daveho/cpu2/hw/alu.sch

## KiCad design hw/alu.sch (2017-08-15)

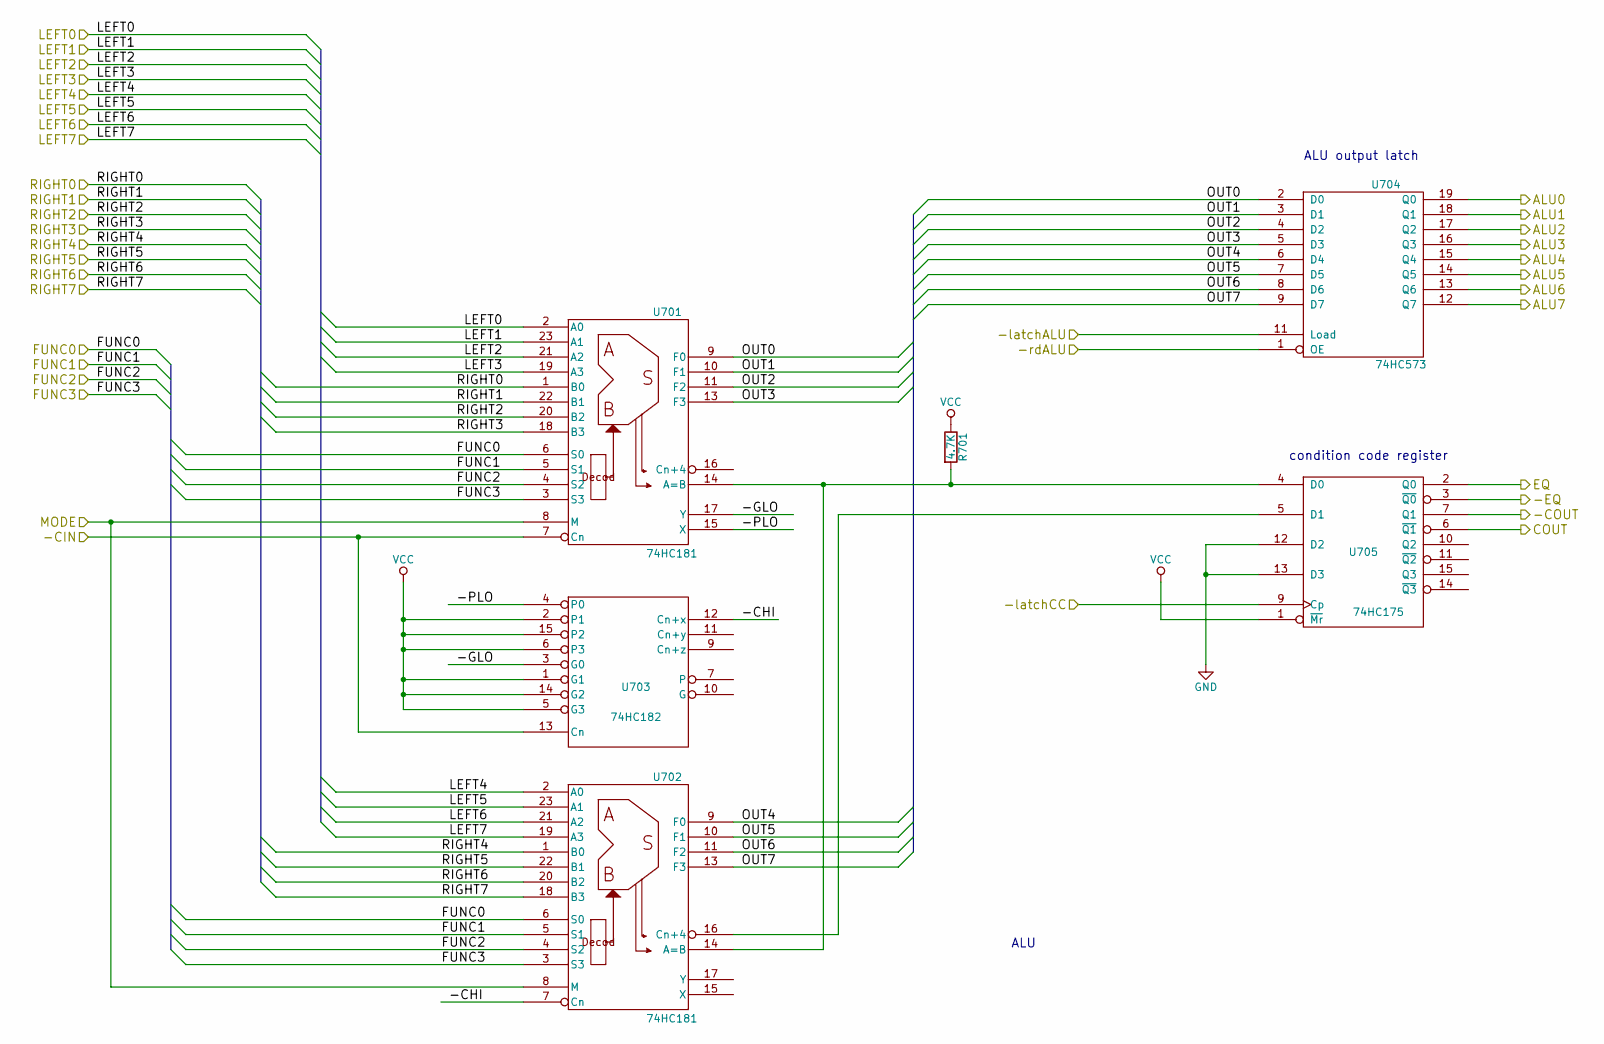
[picture p1: schematic alu.sch]

Parts:
R701: 4.7K
U701, U702: 74HC181
U703: 74HC182
U704: 74HC573
U705: 74HC175

Connections:
-CHI: U702.7 (Cn), U703.12 (Cn+x)
-CIN: U701.7 (Cn), U703.13 (Cn)
-COUT: U705.7 (Q1)
-EQ: U705.3 (~Q0)
-GLO: U701.17 (Y), U703.3 (G0)
-PLO: U701.15 (X), U703.4 (P0)
-latchALU: U704.11 (Load)
-latchCC: U705.9 (Cp)
-rdALU: U704.1 (OE)
ALU0: U704.19 (Q0)
ALU1: U704.18 (Q1)
ALU2: U704.17 (Q2)
ALU3: U704.16 (Q3)
ALU4: U704.15 (Q4)
ALU5: U704.14 (Q5)
ALU6: U704.13 (Q6)
ALU7: U704.12 (Q7)
COUT: U705.6 (~Q1)
EQ: U705.2 (Q0)
FUNC0: U701.6 (S0), U702.6 (S0)
FUNC1: U701.5 (S1), U702.5 (S1)
FUNC2: U701.4 (S2), U702.4 (S2)
FUNC3: U701.3 (S3), U702.3 (S3)
GND: U705.12 (D2), U705.13 (D3)
LEFT0: U701.2 (A0)
LEFT1: U701.23 (A1)
LEFT2: U701.21 (A2)
LEFT3: U701.19 (A3)
LEFT4: U702.2 (A0)
LEFT5: U702.23 (A1)
LEFT6: U702.21 (A2)
LEFT7: U702.19 (A3)
MODE: U701.8 (M), U702.8 (M)
unnamed: R701.2, U701.14 (A=B), U702.14 (A=B), U705.4 (D0)
unnamed: U702.16 (Cn+4), U705.5 (D1)
OUT0: U701.9 (F0), U704.2 (D0)
OUT1: U701.10 (F1), U704.3 (D1)
OUT2: U701.11 (F2), U704.4 (D2)
OUT3: U701.13 (F3), U704.5 (D3)
OUT4: U702.9 (F0), U704.6 (D4)
OUT5: U702.10 (F1), U704.7 (D5)
OUT6: U702.11 (F2), U704.8 (D6)
OUT7: U702.13 (F3), U704.9 (D7)
RIGHT0: U701.1 (B0)
RIGHT1: U701.22 (B1)
RIGHT2: U701.20 (B2)
RIGHT3: U701.18 (B3)
RIGHT4: U702.1 (B0)
RIGHT5: U702.22 (B1)
RIGHT6: U702.20 (B2)
RIGHT7: U702.18 (B3)
VCC: R701.1, U703.1 (G1), U703.2 (P1), U703.5 (G3), U703.6 (P3), U703.14 (G2), U703.15 (P2), U705.1 (~Mr)

Notes on the sheet:
ALU
condition code register
ALU output latch
