daveho/cpu2/hw/bus_ar.sch

## KiCad design hw/bus_ar.sch (2017-07-29)

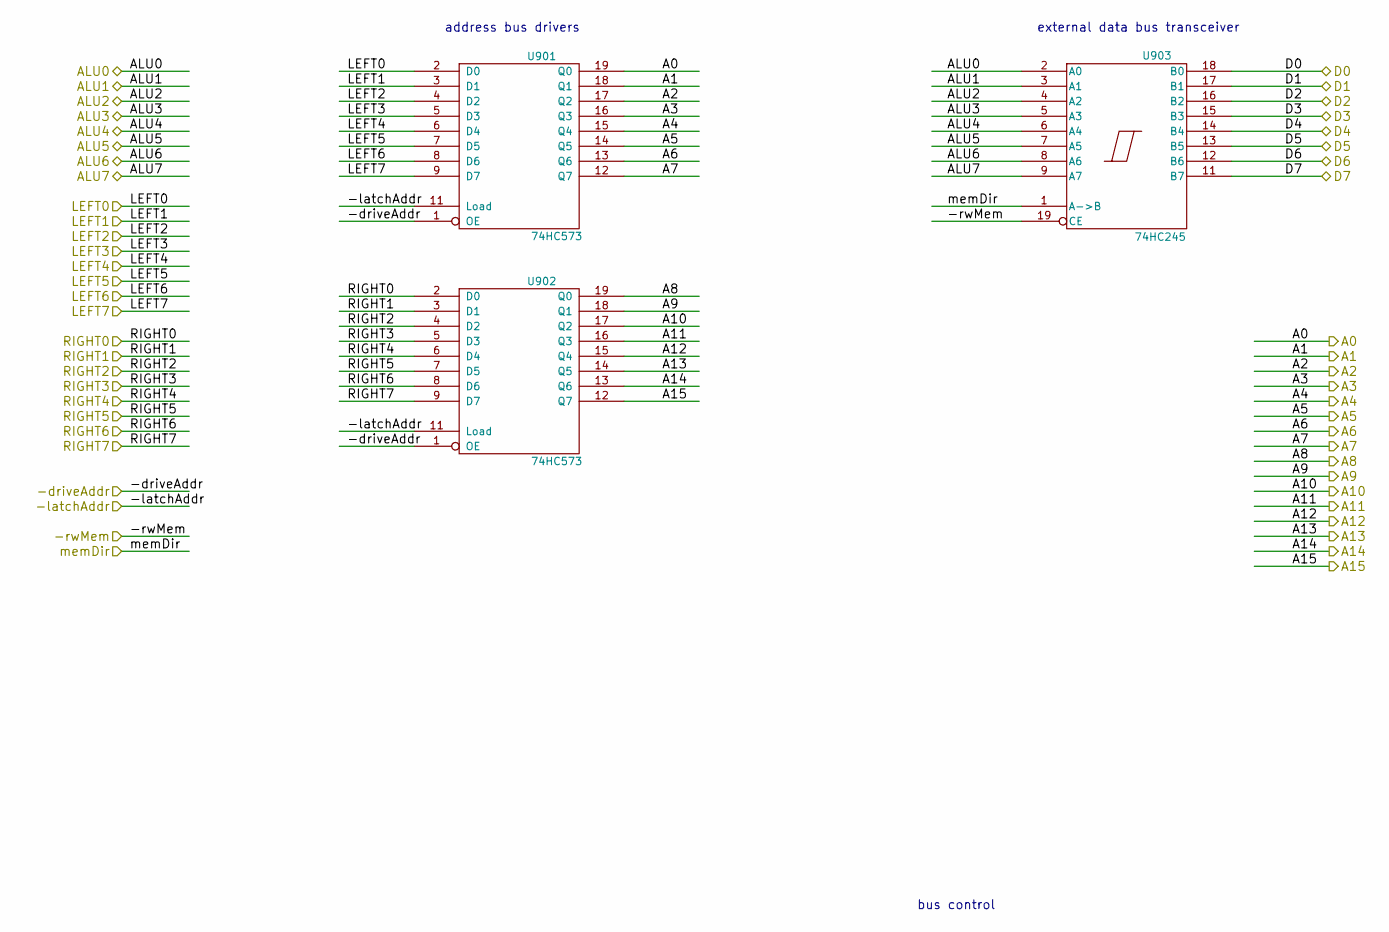
[picture p2: schematic bus_ar.sch]

Parts:
U901, U902: 74HC573
U903: 74HC245

Connections:
-driveAddr: U901.1 (OE), U902.1 (OE)
-latchAddr: U901.11 (Load), U902.11 (Load)
-rwMem: U903.19 (CE)
A0: U901.19 (Q0)
A1: U901.18 (Q1)
A2: U901.17 (Q2)
A3: U901.16 (Q3)
A4: U901.15 (Q4)
A5: U901.14 (Q5)
A6: U901.13 (Q6)
A7: U901.12 (Q7)
A8: U902.19 (Q0)
A9: U902.18 (Q1)
A10: U902.17 (Q2)
A11: U902.16 (Q3)
A12: U902.15 (Q4)
A13: U902.14 (Q5)
A14: U902.13 (Q6)
A15: U902.12 (Q7)
ALU0: U903.2 (A0)
ALU1: U903.3 (A1)
ALU2: U903.4 (A2)
ALU3: U903.5 (A3)
ALU4: U903.6 (A4)
ALU5: U903.7 (A5)
ALU6: U903.8 (A6)
ALU7: U903.9 (A7)
D0: U903.18 (B0)
D1: U903.17 (B1)
D2: U903.16 (B2)
D3: U903.15 (B3)
D4: U903.14 (B4)
D5: U903.13 (B5)
D6: U903.12 (B6)
D7: U903.11 (B7)
LEFT0: U901.2 (D0)
LEFT1: U901.3 (D1)
LEFT2: U901.4 (D2)
LEFT3: U901.5 (D3)
LEFT4: U901.6 (D4)
LEFT5: U901.7 (D5)
LEFT6: U901.8 (D6)
LEFT7: U901.9 (D7)
RIGHT0: U902.2 (D0)
RIGHT1: U902.3 (D1)
RIGHT2: U902.4 (D2)
RIGHT3: U902.5 (D3)
RIGHT4: U902.6 (D4)
RIGHT5: U902.7 (D5)
RIGHT6: U902.8 (D6)
RIGHT7: U902.9 (D7)
memDir: U903.1 (A->B)

Notes on the sheet:
bus control
address bus drivers
external data bus transceiver
