daveho/cpu2/hw/clockrst.sch

## KiCad design hw/clockrst.sch (2017-08-15)

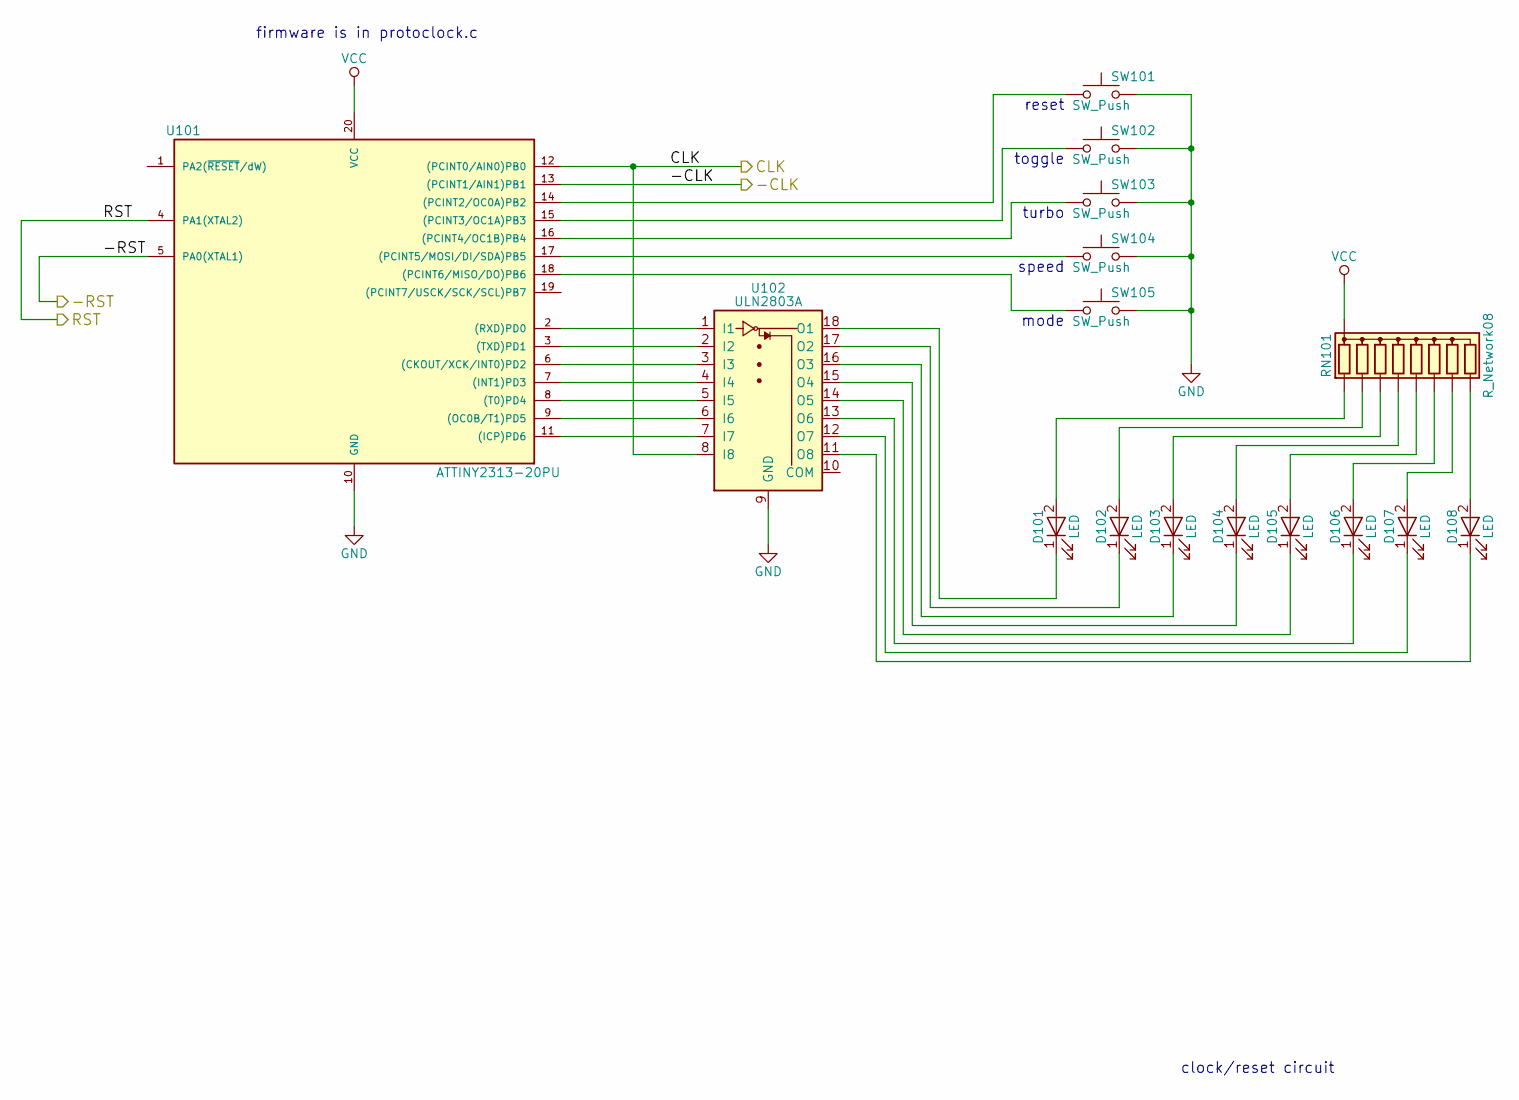
[picture p3: schematic clockrst.sch]

Parts:
D101, D102, D103, D104, D105, D106, D107, D108: LED
RN101: R_Network08; R_Array_SIP9
SW101, SW102, SW103, SW104, SW105: SW_Push
U101: ATTINY2313-20PU; DIP-20_W7.62mm
U102: ULN2803A

Connections:
-CLK: U101.13 ((PCINT1/AIN1)PB1)
-RST: U101.5 (PA0(XTAL1))
CLK: U101.12 ((PCINT0/AIN0)PB0), U102.8 (I8)
GND: SW101.2, SW102.2, SW103.2, SW104.2, SW105.2, U101.10 (GND), U102.9 (GND)
unnamed: D101.1 (K), U102.18 (O1)
unnamed: D101.2 (A), RN101.2 (R1)
unnamed: D102.1 (K), U102.17 (O2)
unnamed: D102.2 (A), RN101.3 (R2)
unnamed: D103.1 (K), U102.16 (O3)
unnamed: D103.2 (A), RN101.4 (R3)
unnamed: D104.1 (K), U102.15 (O4)
unnamed: D104.2 (A), RN101.5 (R4)
unnamed: D105.1 (K), U102.14 (O5)
unnamed: D105.2 (A), RN101.6 (R5)
unnamed: D106.1 (K), U102.13 (O6)
unnamed: D106.2 (A), RN101.7 (R6)
unnamed: D107.1 (K), U102.12 (O7)
unnamed: D107.2 (A), RN101.8 (R7)
unnamed: D108.1 (K), U102.11 (O8)
unnamed: D108.2 (A), RN101.9 (R8)
unnamed: SW101.1, U101.14 ((PCINT2/OC0A)PB2)
unnamed: SW102.1, U101.15 ((PCINT3/OC1A)PB3)
unnamed: SW103.1, U101.16 ((PCINT4/OC1B)PB4)
unnamed: SW104.1, U101.17 ((PCINT5/MOSI/DI/SDA)PB5)
unnamed: SW105.1, U101.18 ((PCINT6/MISO/DO)PB6)
unnamed: U101.2 ((RXD)PD0), U102.1 (I1)
unnamed: U101.3 ((TXD)PD1), U102.2 (I2)
unnamed: U101.6 ((CKOUT/XCK/INT0)PD2), U102.3 (I3)
unnamed: U101.7 ((INT1)PD3), U102.4 (I4)
unnamed: U101.8 ((T0)PD4), U102.5 (I5)
unnamed: U101.9 ((OC0B/T1)PD5), U102.6 (I6)
unnamed: U101.11 ((ICP)PD6), U102.7 (I7)
RST: U101.4 (PA1(XTAL2))
VCC: RN101.1 (common), U101.20 (VCC)

Notes on the sheet:
mode
speed
turbo
toggle
reset
clock/reset circuit
firmware is in protoclock.c
