daveho/cpu2/hw/earlyrst.sch

## KiCad design hw/earlyrst.sch (2017-08-15)

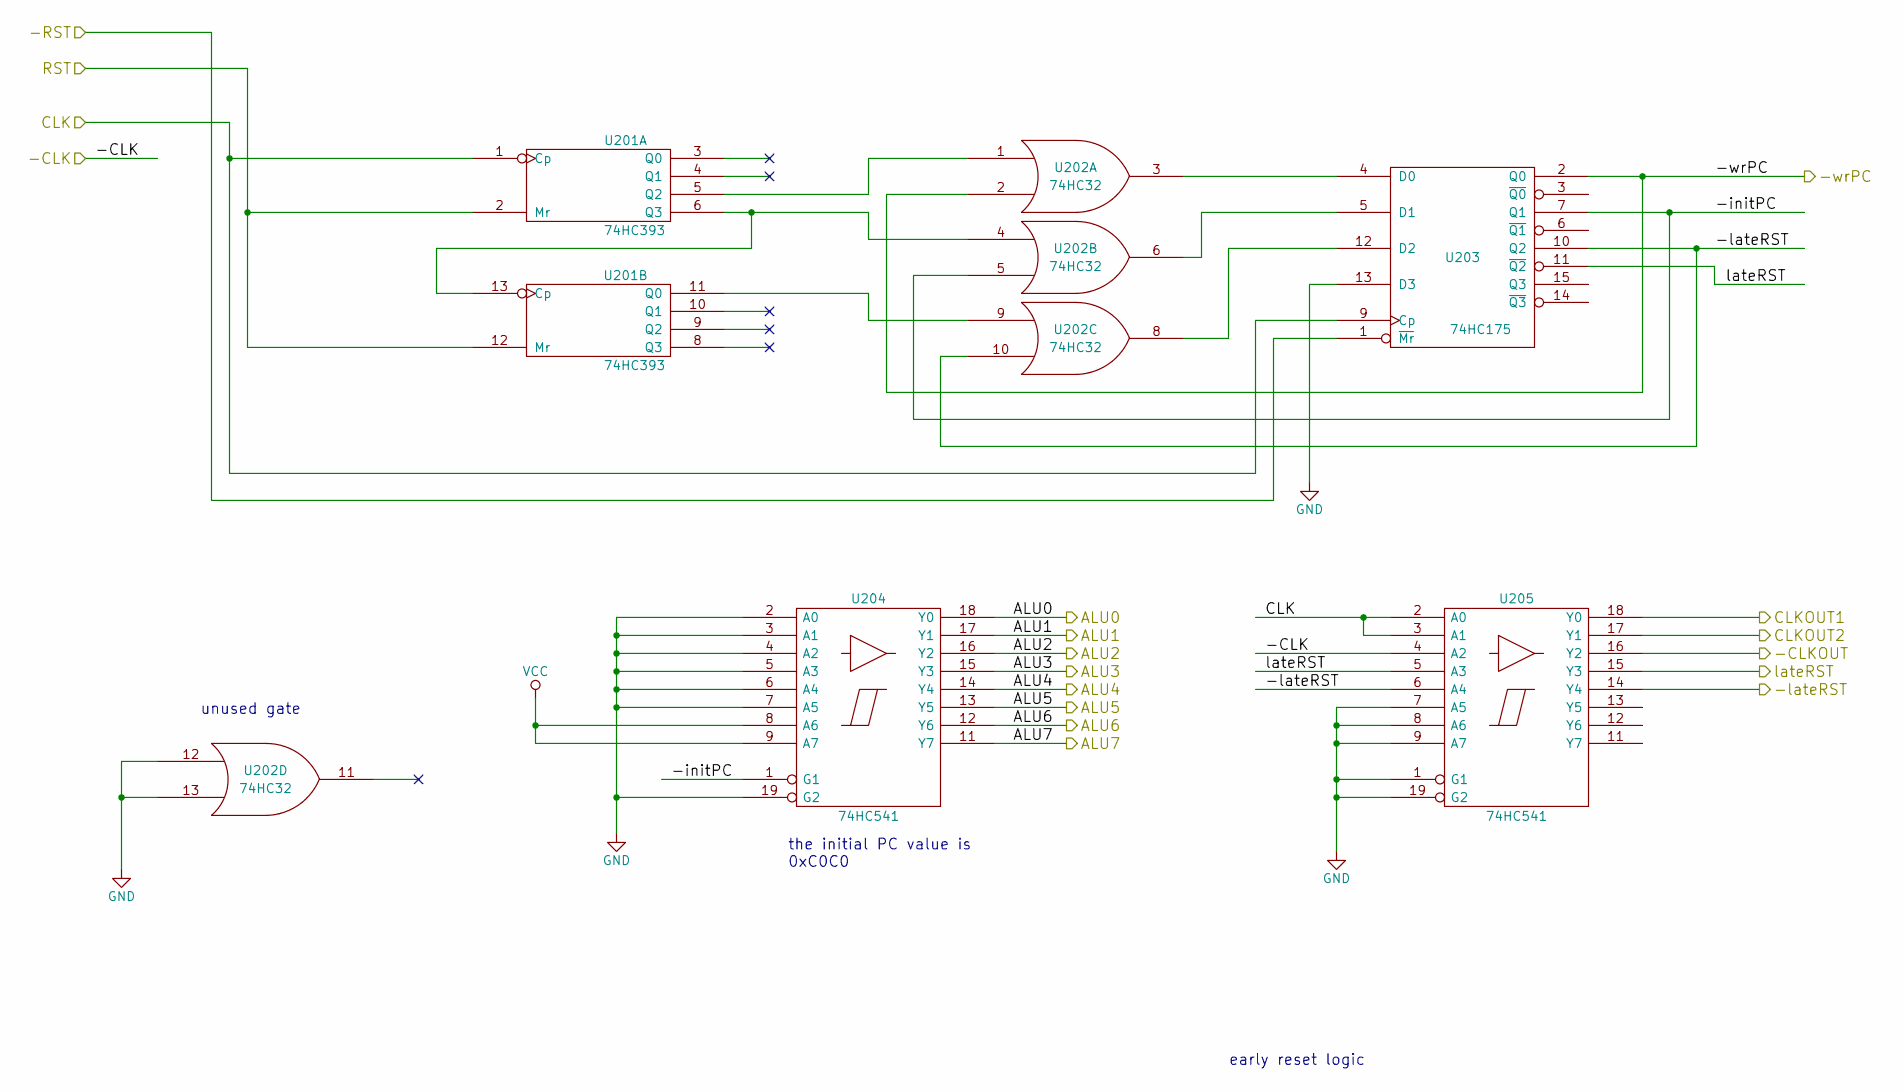
[picture p4: schematic earlyrst.sch]

Parts:
U201: 74HC393
U202: 74HC32
U203: 74HC175
U204, U205: 74HC541

Connections:
-CLK: U205.4 (A2)
-CLKOUT: U205.16 (Y2)
-RST: U203.1 (~Mr)
-initPC: U202.5, U203.7 (Q1), U204.1 (G1)
-lateRST: U202.10, U203.10 (Q2), U205.6 (A4), U205.14 (Y4)
-wrPC: U202.2, U203.2 (Q0)
ALU0: U204.18 (Y0)
ALU1: U204.17 (Y1)
ALU2: U204.16 (Y2)
ALU3: U204.15 (Y3)
ALU4: U204.14 (Y4)
ALU5: U204.13 (Y5)
ALU6: U204.12 (Y6)
ALU7: U204.11 (Y7)
CLK: U201.1 (Cp), U203.9 (Cp), U205.2 (A0), U205.3 (A1)
CLKOUT1: U205.18 (Y0)
CLKOUT2: U205.17 (Y1)
GND: U202.12, U202.13, U203.13 (D3), U204.2 (A0), U204.3 (A1), U204.4 (A2), U204.5 (A3), U204.6 (A4), U204.7 (A5), U204.19 (G2), U205.1 (G1), U205.7 (A5), U205.8 (A6), U205.9 (A7), U205.19 (G2)
unnamed: U201.5 (Q2), U202.1
unnamed: U201.11 (Q0), U202.9
unnamed: U201.6 (Q3), U201.13 (Cp), U202.4
unnamed: U202.3, U203.4 (D0)
unnamed: U202.6, U203.5 (D1)
unnamed: U202.8, U203.12 (D2)
RST: U201.2 (Mr), U201.12 (Mr)
VCC: U204.8 (A6), U204.9 (A7)
lateRST: U203.11 (~Q2), U205.5 (A3), U205.15 (Y3)

Notes on the sheet:
early reset logic
the initial PC value is 0xC0C0
unused gate
