daveho/cpu2/hw/gpreg.sch

## KiCad design hw/gpreg.sch (2017-06-29)

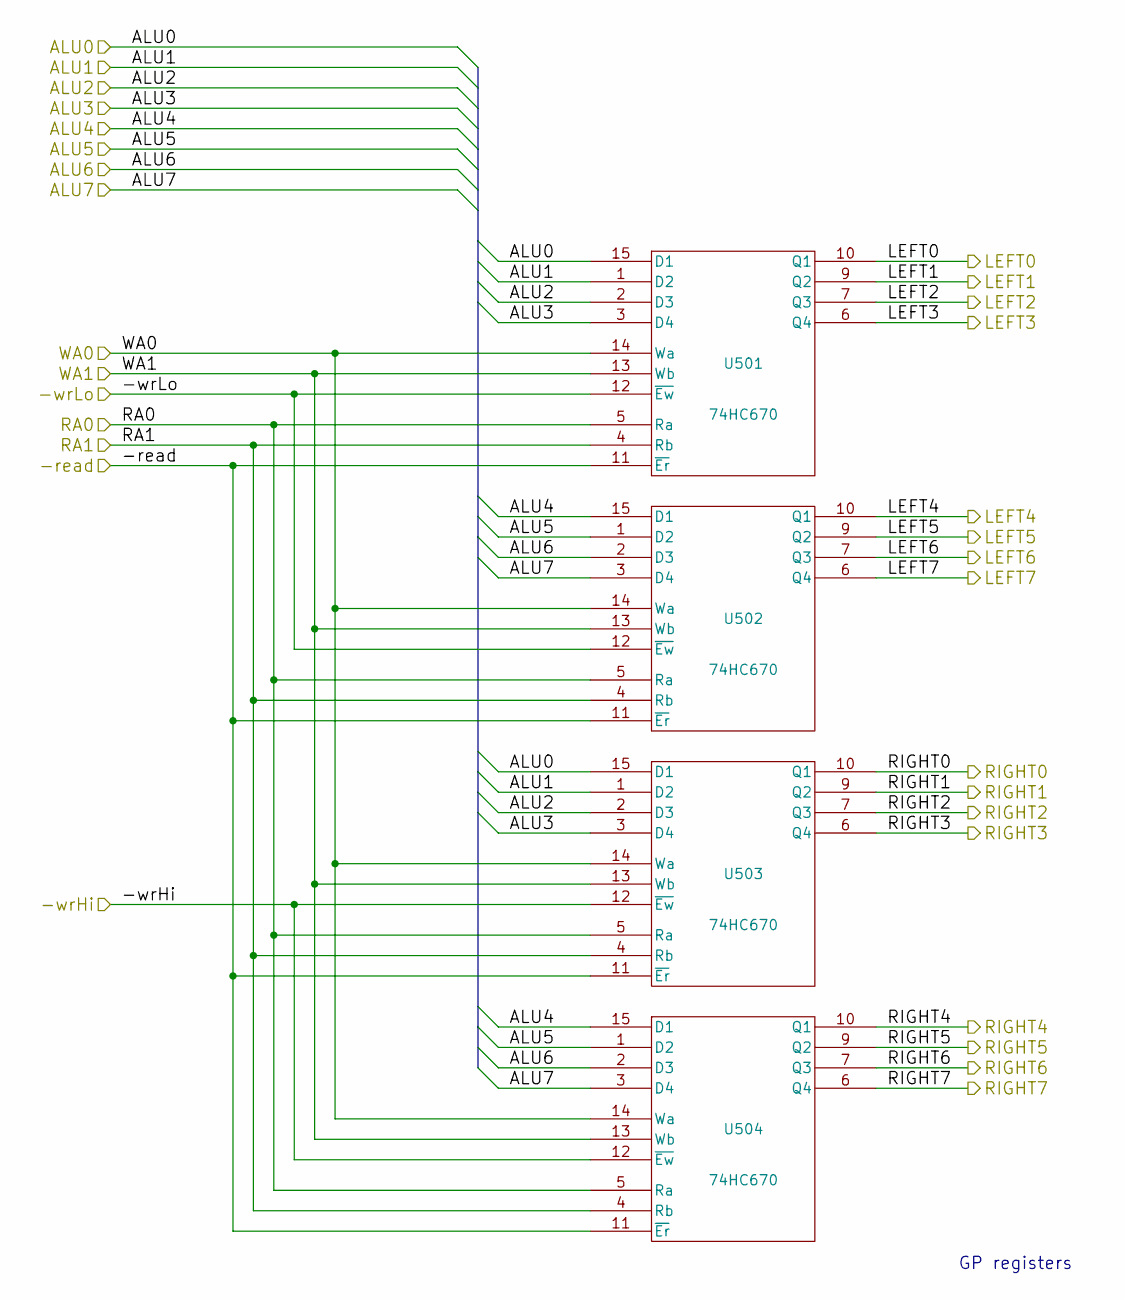
[picture p5: schematic gpreg.sch]

Parts:
U501, U502, U503, U504: 74HC670

Connections:
-read: U501.11 (~Er), U502.11 (~Er), U503.11 (~Er), U504.11 (~Er)
-wrHi: U503.12 (~Ew), U504.12 (~Ew)
-wrLo: U501.12 (~Ew), U502.12 (~Ew)
ALU0: U501.15 (D1), U503.15 (D1)
ALU1: U501.1 (D2), U503.1 (D2)
ALU2: U501.2 (D3), U503.2 (D3)
ALU3: U501.3 (D4), U503.3 (D4)
ALU4: U502.15 (D1), U504.15 (D1)
ALU5: U502.1 (D2), U504.1 (D2)
ALU6: U502.2 (D3), U504.2 (D3)
ALU7: U502.3 (D4), U504.3 (D4)
LEFT0: U501.10 (Q1)
LEFT1: U501.9 (Q2)
LEFT2: U501.7 (Q3)
LEFT3: U501.6 (Q4)
LEFT4: U502.10 (Q1)
LEFT5: U502.9 (Q2)
LEFT6: U502.7 (Q3)
LEFT7: U502.6 (Q4)
RA0: U501.5 (Ra), U502.5 (Ra), U503.5 (Ra), U504.5 (Ra)
RA1: U501.4 (Rb), U502.4 (Rb), U503.4 (Rb), U504.4 (Rb)
RIGHT0: U503.10 (Q1)
RIGHT1: U503.9 (Q2)
RIGHT2: U503.7 (Q3)
RIGHT3: U503.6 (Q4)
RIGHT4: U504.10 (Q1)
RIGHT5: U504.9 (Q2)
RIGHT6: U504.7 (Q3)
RIGHT7: U504.6 (Q4)
WA0: U501.14 (Wa), U502.14 (Wa), U503.14 (Wa), U504.14 (Wa)
WA1: U501.13 (Wb), U502.13 (Wb), U503.13 (Wb), U504.13 (Wb)

Notes on the sheet:
GP registers
