daveho/cpu2/hw/opfetch.sch

## KiCad design hw/opfetch.sch (2017-08-19)

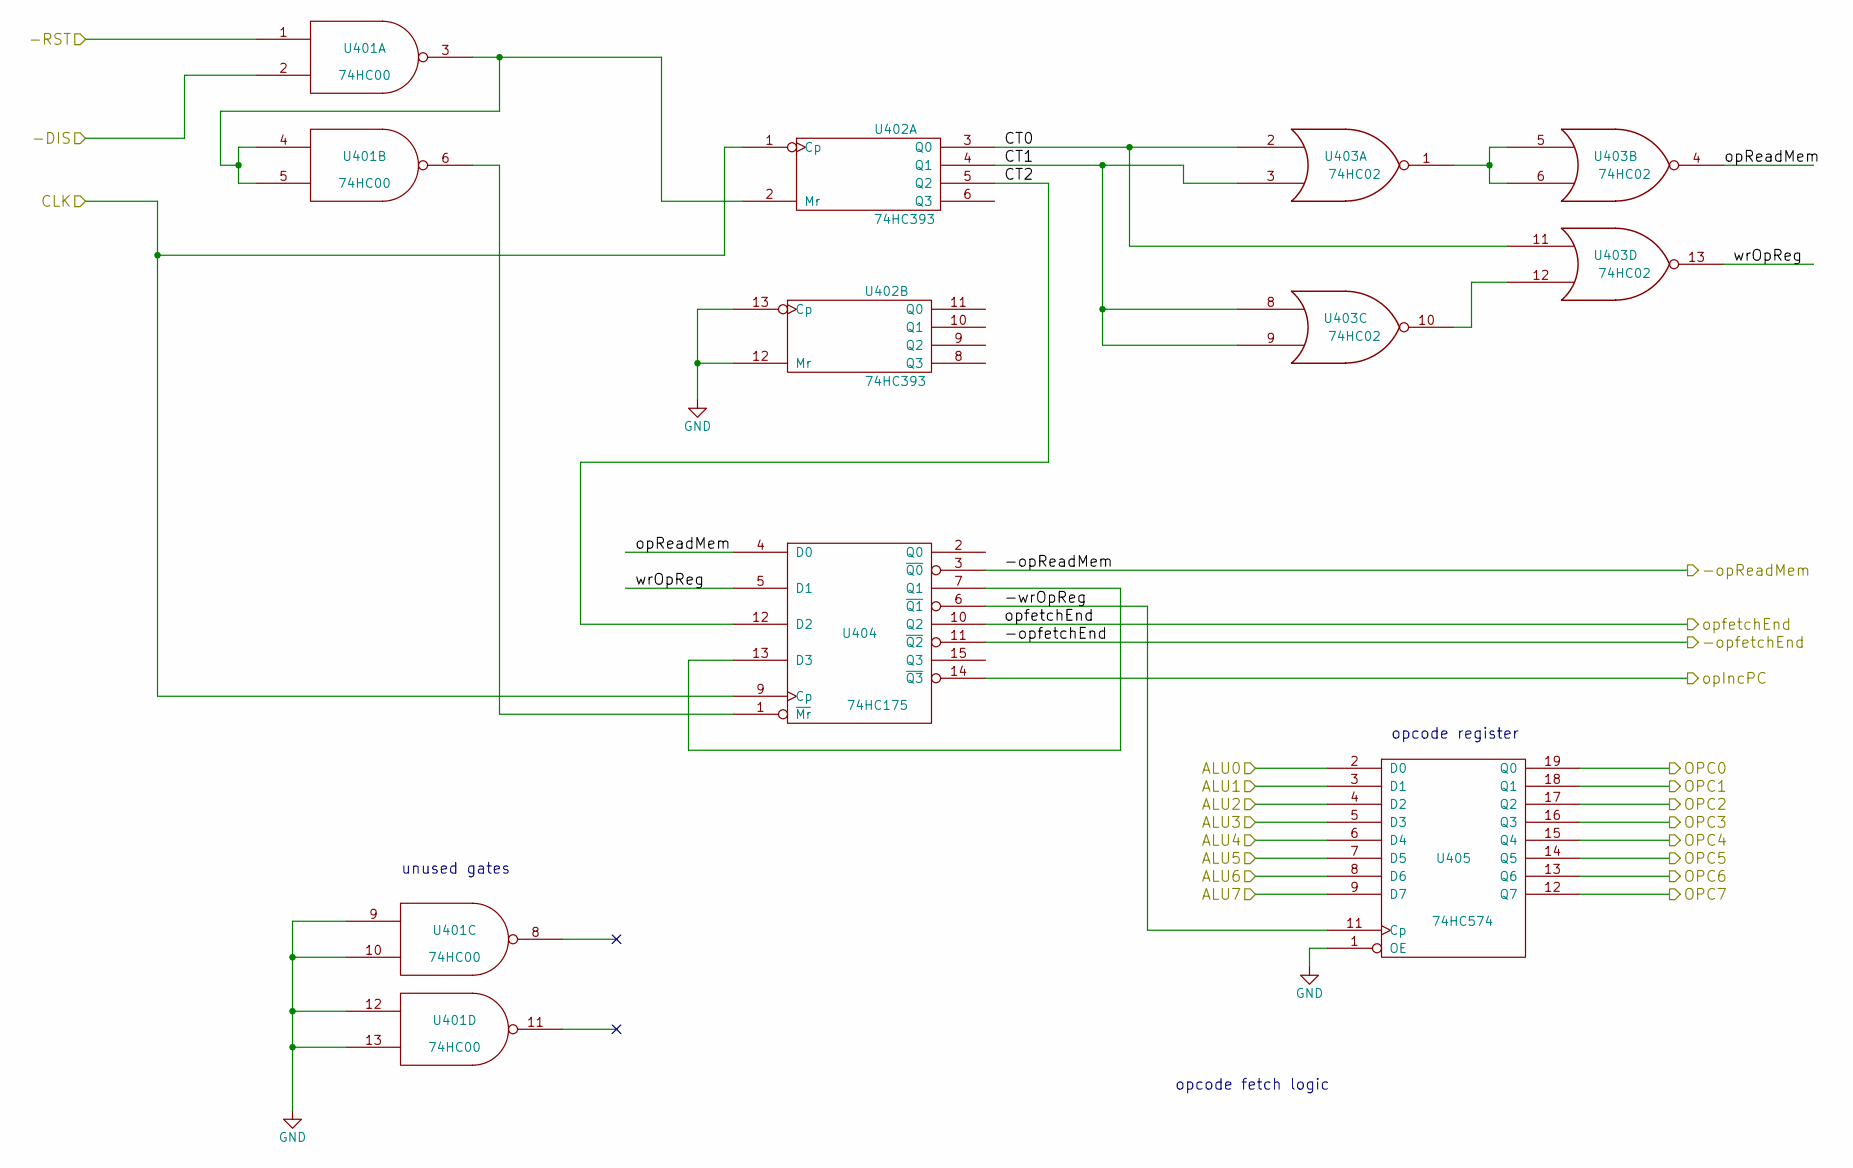
[picture p6: schematic opfetch.sch]

Parts:
U401: 74HC00
U402: 74HC393
U403: 74HC02
U404: 74HC175
U405: 74HC574

Connections:
-DIS: U401.2
-RST: U401.1
-opReadMem: U404.3 (~Q0)
-opfetchEnd: U404.11 (~Q2)
-wrOpReg: U404.6 (~Q1), U405.11 (Cp)
ALU0: U405.2 (D0)
ALU1: U405.3 (D1)
ALU2: U405.4 (D2)
ALU3: U405.5 (D3)
ALU4: U405.6 (D4)
ALU5: U405.7 (D5)
ALU6: U405.8 (D6)
ALU7: U405.9 (D7)
CLK: U402.1 (Cp), U404.9 (Cp)
CT0: U402.3 (Q0), U403.2, U403.11
CT1: U402.4 (Q1), U403.3, U403.8, U403.9
CT2: U402.5 (Q2), U404.12 (D2)
GND: U401.9, U401.10, U401.12, U401.13, U402.12 (Mr), U402.13 (Cp), U405.1 (OE)
unnamed: U401.3, U401.4, U401.5, U402.2 (Mr)
unnamed: U401.6, U404.1 (~Mr)
unnamed: U403.1, U403.5, U403.6
unnamed: U403.10, U403.12
unnamed: U404.7 (Q1), U404.13 (D3)
OPC0: U405.19 (Q0)
OPC1: U405.18 (Q1)
OPC2: U405.17 (Q2)
OPC3: U405.16 (Q3)
OPC4: U405.15 (Q4)
OPC5: U405.14 (Q5)
OPC6: U405.13 (Q6)
OPC7: U405.12 (Q7)
opIncPC: U404.14 (~Q3)
opReadMem: U403.4, U404.4 (D0)
opfetchEnd: U404.10 (Q2)
wrOpReg: U403.13, U404.5 (D1)

Notes on the sheet:
unused gates
opcode register
opcode fetch logic
