daveho/cpu2/hw/pc.sch

## KiCad design hw/pc.sch (2017-08-10)

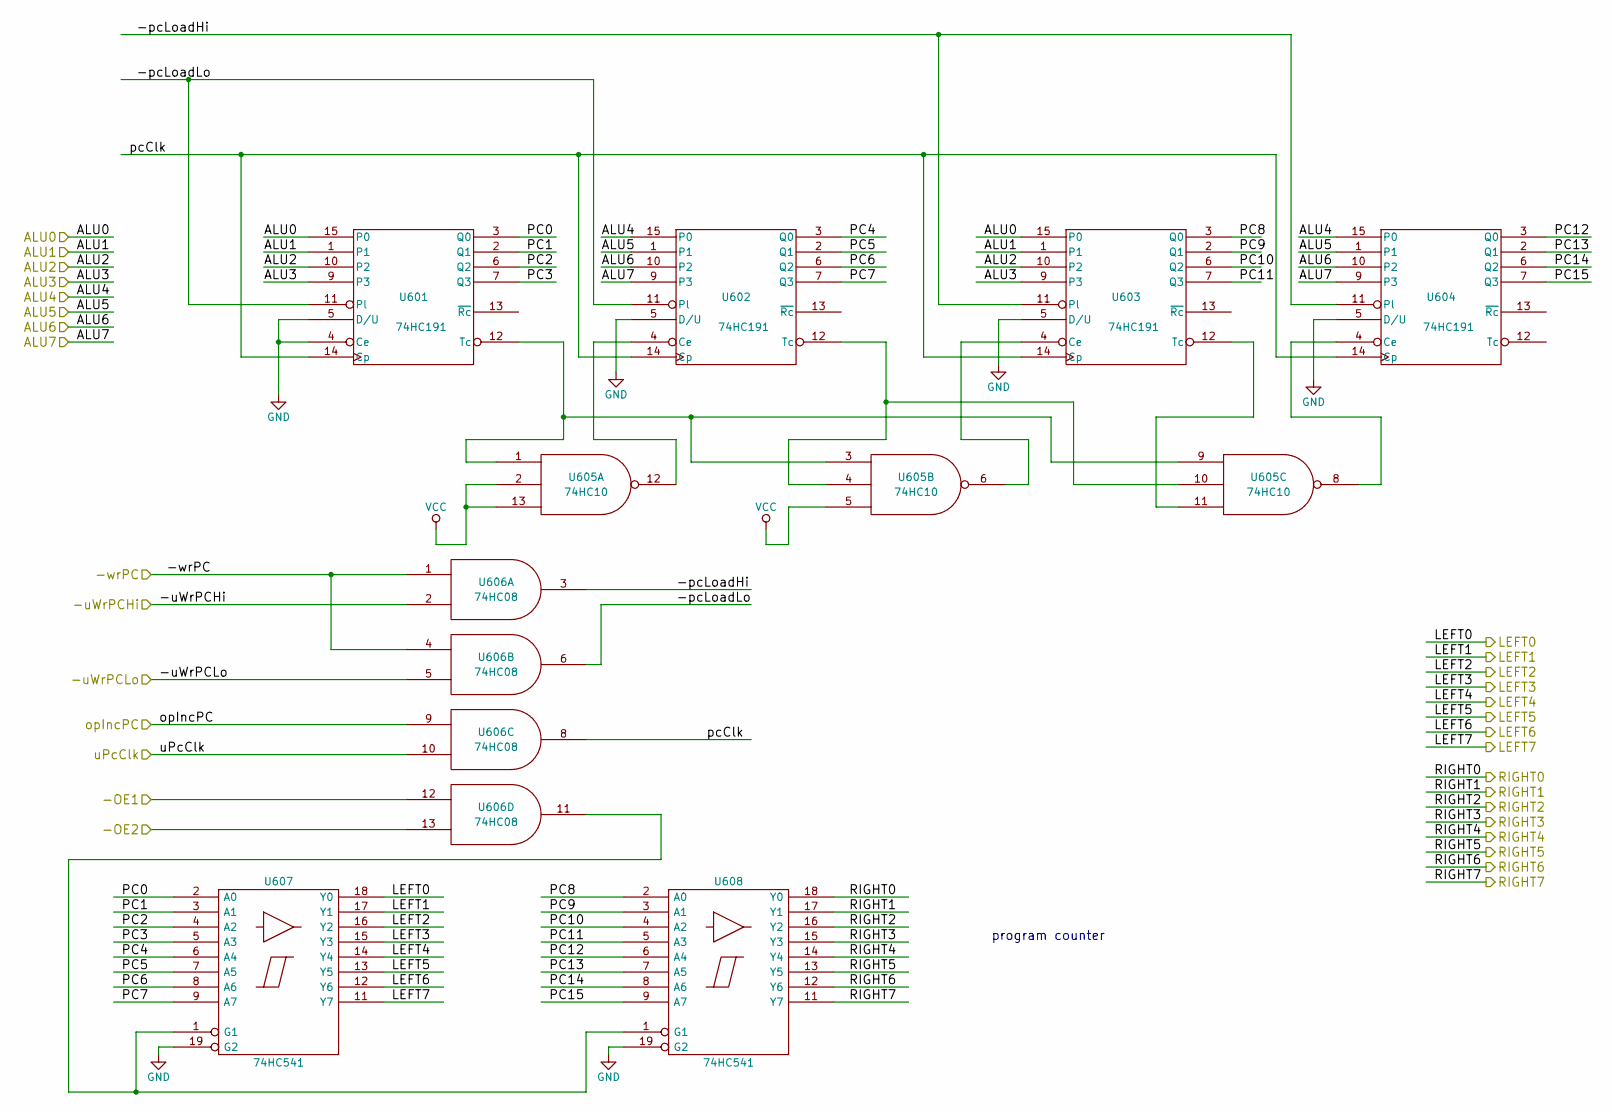
[picture p7: schematic pc.sch]

Parts:
U601, U602, U603, U604: 74HC191
U605: 74HC10
U606: 74HC08
U607, U608: 74HC541

Connections:
-OE1: U606.12
-OE2: U606.13
-pcLoadHi: U603.11 (Pl), U604.11 (Pl), U606.3
-pcLoadLo: U601.11 (Pl), U602.11 (Pl), U606.6
-uWrPCHi: U606.2
-uWrPCLo: U606.5
-wrPC: U606.1, U606.4
ALU0: U601.15 (P0), U603.15 (P0)
ALU1: U601.1, U603.1
ALU2: U601.10 (P2), U603.10 (P2)
ALU3: U601.9 (P3), U603.9 (P3)
ALU4: U602.15 (P0), U604.15 (P0)
ALU5: U602.1, U604.1
ALU6: U602.10 (P2), U604.10 (P2)
ALU7: U602.9 (P3), U604.9 (P3)
GND: U601.4 (Ce), U601.5 (D/U), U602.5 (D/U), U603.5 (D/U), U604.5 (D/U), U607.19 (G2), U608.19 (G2)
LEFT0: U607.18 (Y0)
LEFT1: U607.17 (Y1)
LEFT2: U607.16 (Y2)
LEFT3: U607.15 (Y3)
LEFT4: U607.14 (Y4)
LEFT5: U607.13 (Y5)
LEFT6: U607.12 (Y6)
LEFT7: U607.11 (Y7)
unnamed: U601.12 (Tc), U605.1, U605.3, U605.9
unnamed: U602.4 (Ce), U605.12
unnamed: U602.12 (Tc), U605.4, U605.10
unnamed: U603.4 (Ce), U605.6
unnamed: U603.12 (Tc), U605.11
unnamed: U604.4 (Ce), U605.8
unnamed: U606.11, U607.1 (G1), U608.1 (G1)
PC0: U601.3 (Q0), U607.2 (A0)
PC1: U601.2 (Q1), U607.3 (A1)
PC2: U601.6 (Q2), U607.4 (A2)
PC3: U601.7 (Q3), U607.5 (A3)
PC4: U602.3 (Q0), U607.6 (A4)
PC5: U602.2 (Q1), U607.7 (A5)
PC6: U602.6 (Q2), U607.8 (A6)
PC7: U602.7 (Q3), U607.9 (A7)
PC8: U603.3 (Q0), U608.2 (A0)
PC9: U603.2 (Q1), U608.3 (A1)
PC10: U603.6 (Q2), U608.4 (A2)
PC11: U603.7 (Q3), U608.5 (A3)
PC12: U604.3 (Q0), U608.6 (A4)
PC13: U604.2 (Q1), U608.7 (A5)
PC14: U604.6 (Q2), U608.8 (A6)
PC15: U604.7 (Q3), U608.9 (A7)
RIGHT0: U608.18 (Y0)
RIGHT1: U608.17 (Y1)
RIGHT2: U608.16 (Y2)
RIGHT3: U608.15 (Y3)
RIGHT4: U608.14 (Y4)
RIGHT5: U608.13 (Y5)
RIGHT6: U608.12 (Y6)
RIGHT7: U608.11 (Y7)
VCC: U605.2, U605.5, U605.13
opIncPC: U606.9
pcClk: U601.14 (Cp), U602.14 (Cp), U603.14 (Cp), U604.14 (Cp), U606.8
uPcClk: U606.10

Notes on the sheet:
program counter
