daveho/cpu2/hw/phase.sch

## KiCad design hw/phase.sch (2017-08-17)

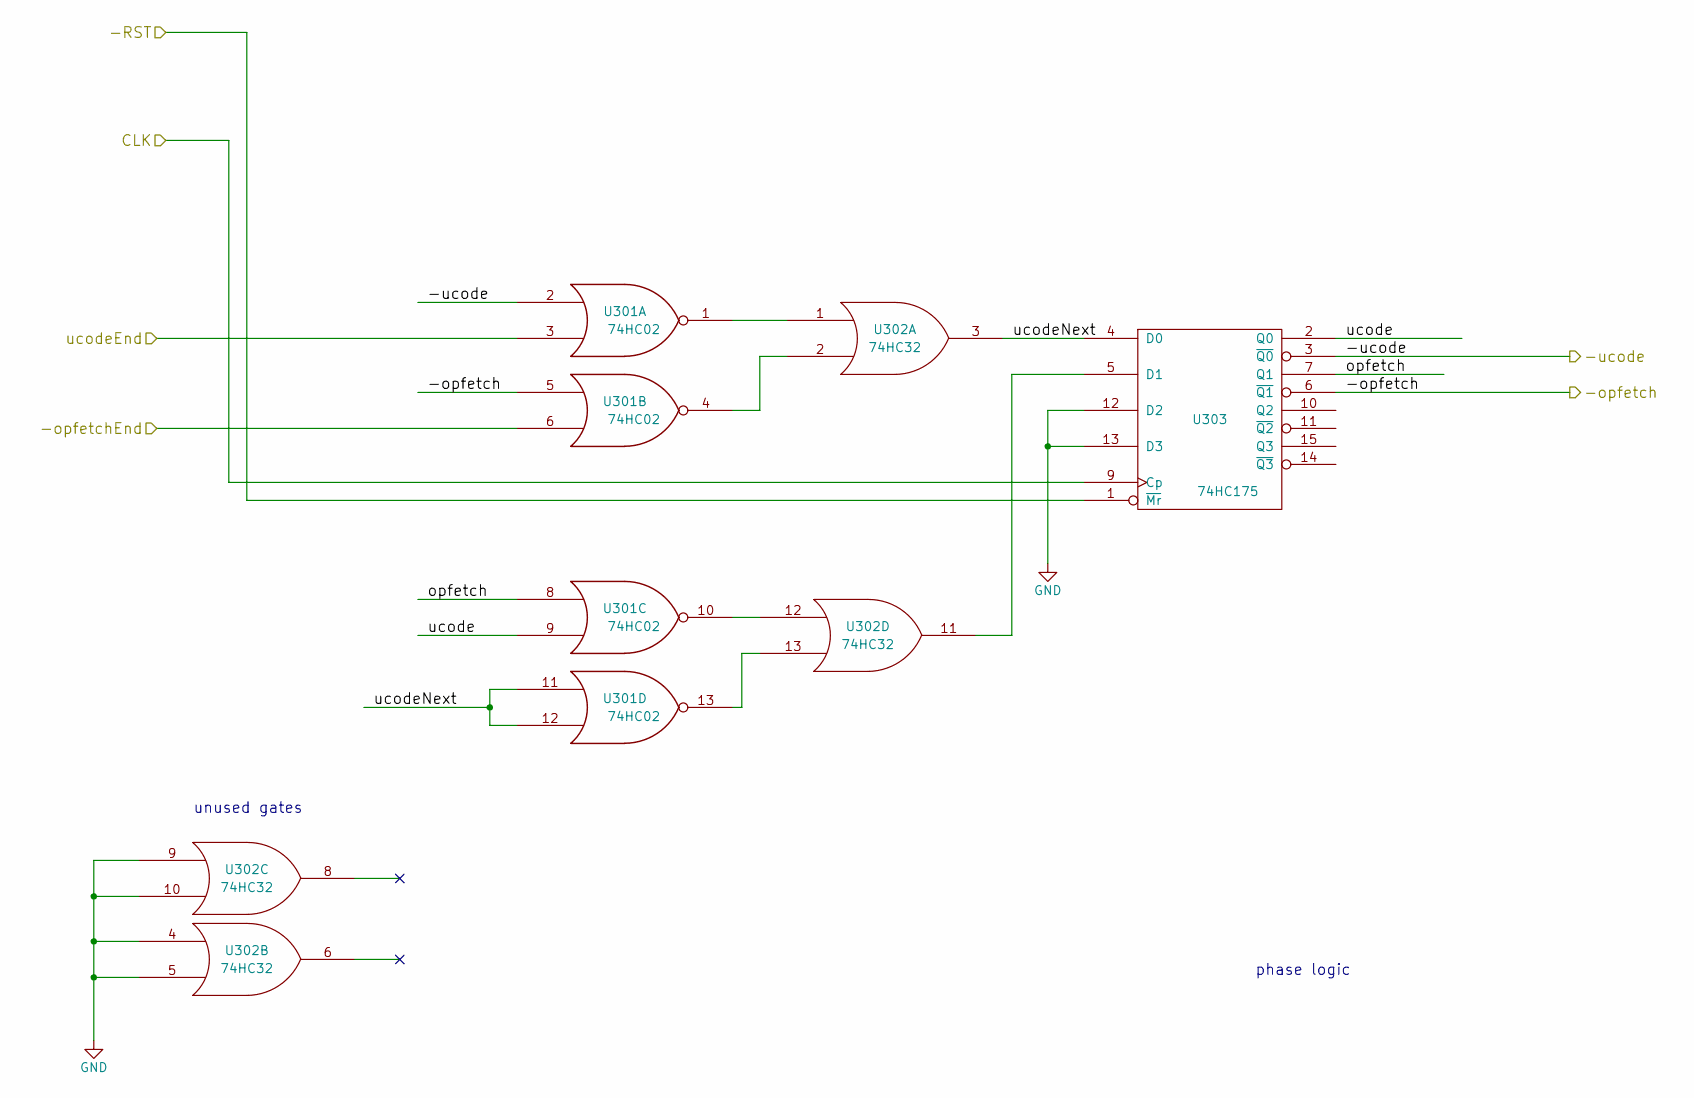
[picture p8: schematic phase.sch]

Parts:
U301: 74HC02
U302: 74HC32
U303: 74HC175

Connections:
-RST: U303.1 (~Mr)
-opfetch: U301.5, U303.6 (~Q1)
-opfetchEnd: U301.6
-ucode: U301.2, U303.3 (~Q0)
CLK: U303.9 (Cp)
GND: U302.4, U302.5, U302.9, U302.10, U303.12 (D2), U303.13 (D3)
unnamed: U301.1, U302.1
unnamed: U301.4, U302.2
unnamed: U301.10, U302.12
unnamed: U301.13, U302.13
unnamed: U302.11, U303.5 (D1)
opfetch: U301.8, U303.7 (Q1)
ucode: U301.9, U303.2 (Q0)
ucodeEnd: U301.3
ucodeNext: U301.11, U301.12, U302.3, U303.4 (D0)

Notes on the sheet:
phase logic
unused gates
