daveho/cpu2/hw/ucode2.sch

## KiCad design hw/ucode2.sch (2017-08-15)

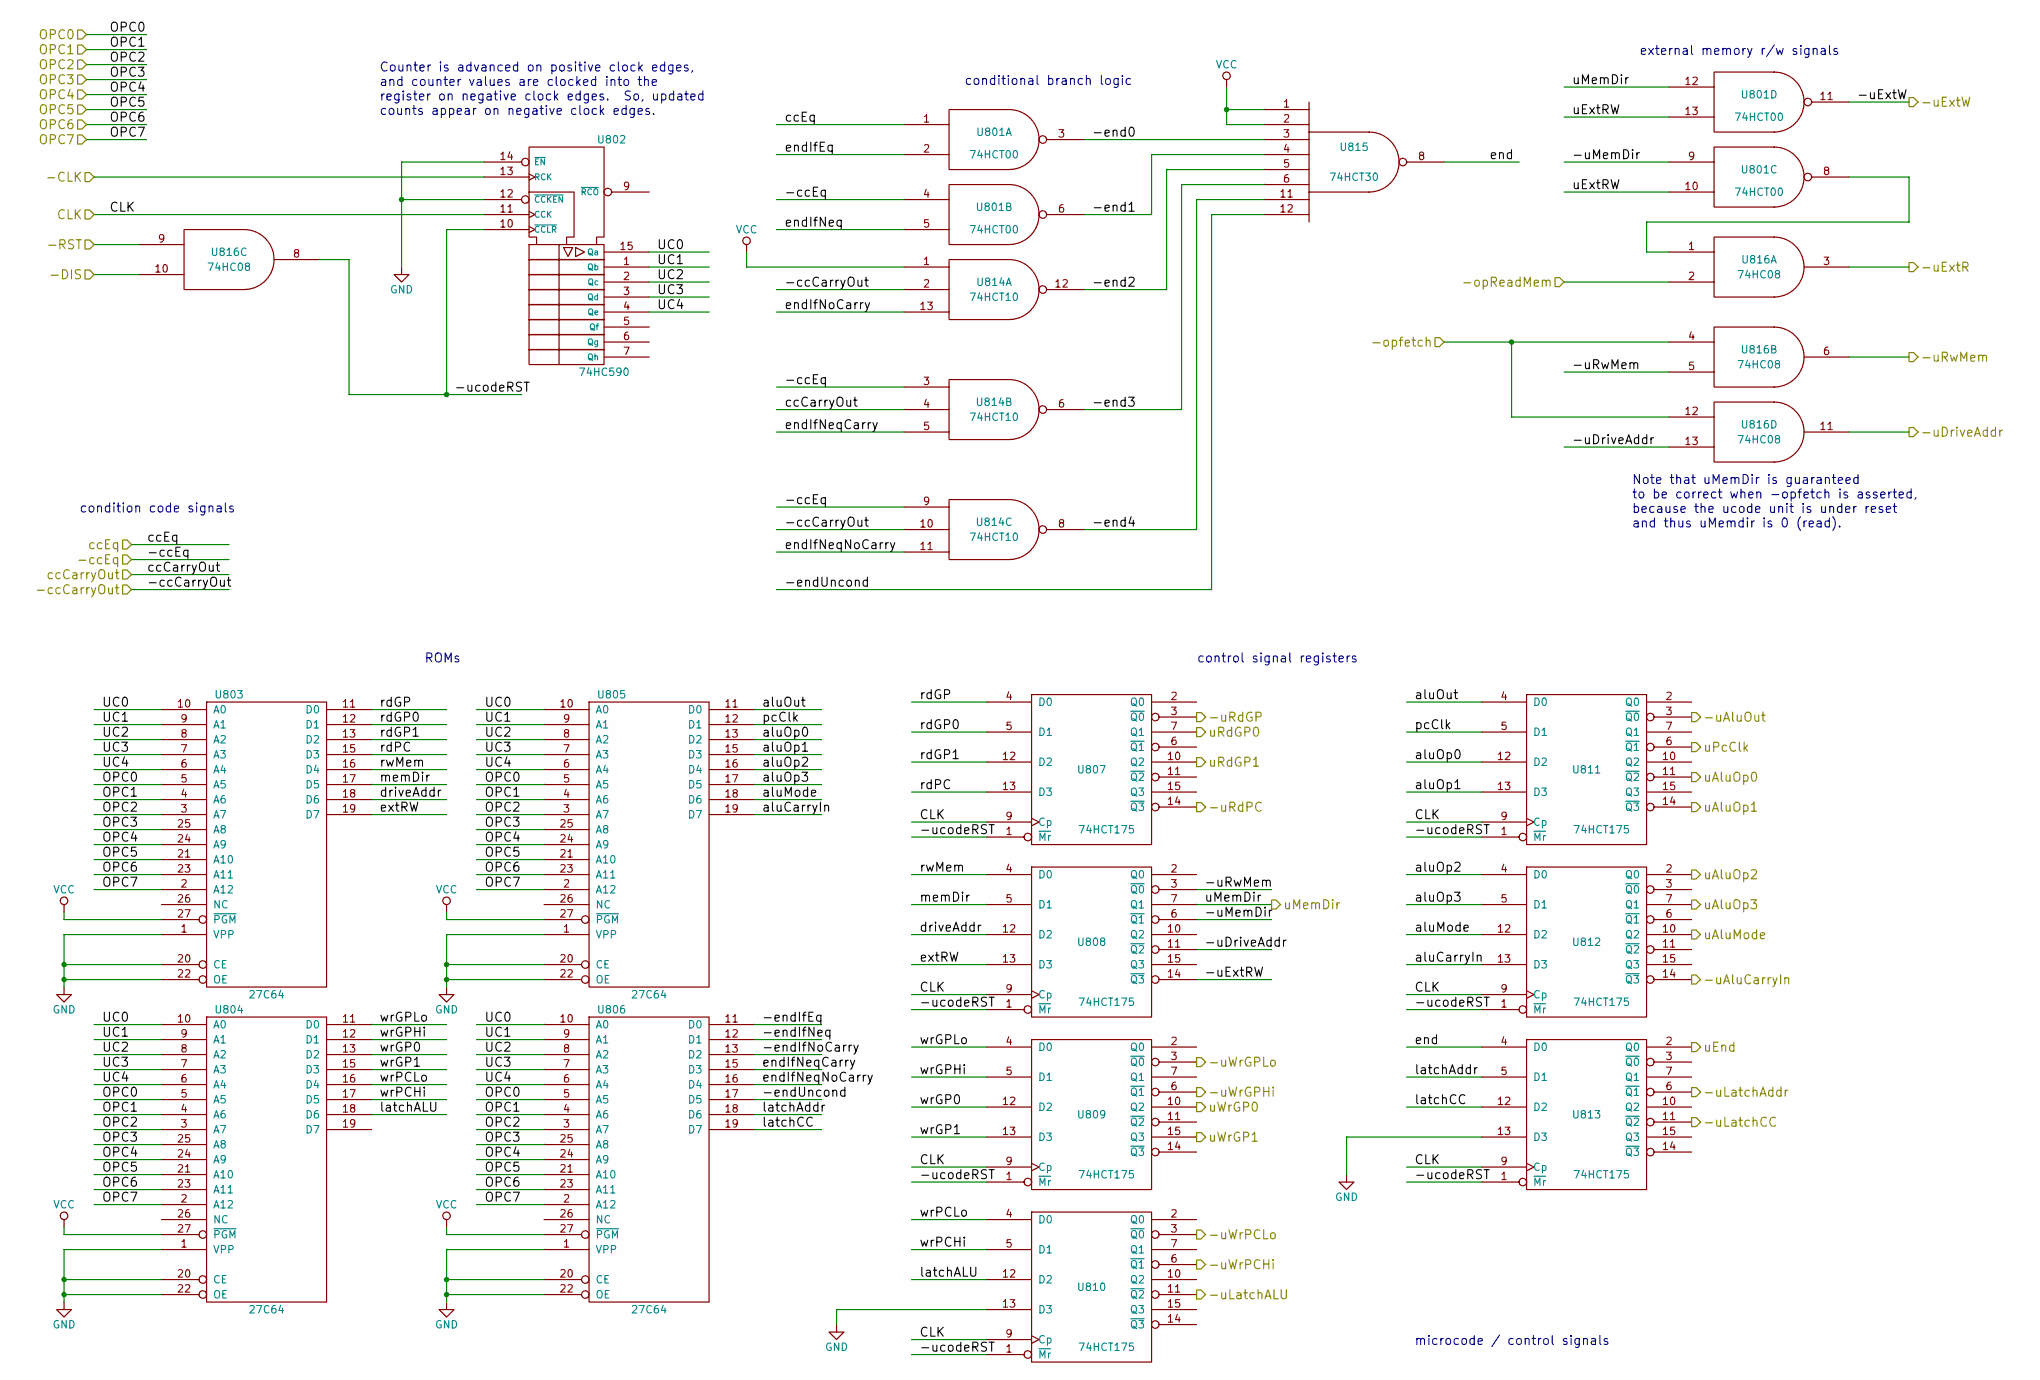
[picture p9: schematic ucode2.sch]

Parts:
U801: 74HCT00
U802: 74HC590
U803, U804, U805, U806: 27C64
U807, U808, U809, U810, U811, U812, U813: 74HCT175
U814: 74HCT10
U815: 74HCT30
U816: 74HC08

Connections:
-CLK: U802.13 (RCK)
-DIS: U816.10
-RST: U816.9
-ccCarryOut: U814.2, U814.10
-ccEq: U801.4, U814.3, U814.9
-end0: U801.3, U815.3
-end1: U801.6, U815.4
-end2: U814.12, U815.5
-end3: U814.6, U815.6
-end4: U814.8, U815.11
-endIfEq: U806.11 (D0)
-endIfNeq: U806.12 (D1)
-endIfNoCarry: U806.13 (D2)
-endUncond: U806.17 (D5), U815.12
-opReadMem: U816.2
-opfetch: U816.4, U816.12
-uAluCarryIn: U812.14 (~Q3)
-uAluOut: U811.3 (~Q0)
-uDriveAddr: U808.11 (~Q2), U816.11, U816.13
-uExtR: U816.3
-uExtRW: U808.14 (~Q3)
-uExtW: U801.11
-uLatchALU: U810.11 (~Q2)
-uLatchAddr: U813.6 (~Q1)
-uLatchCC: U813.11 (~Q2)
-uMemDir: U801.9, U808.6 (~Q1)
-uRdGP: U807.3 (~Q0)
-uRdPC: U807.14 (~Q3)
-uRwMem: U808.3 (~Q0), U816.5, U816.6
-uWrGPHi: U809.6 (~Q1)
-uWrGPLo: U809.3 (~Q0)
-uWrPCHi: U810.6 (~Q1)
-uWrPCLo: U810.3 (~Q0)
-ucodeRST: U802.10 (~CCLR), U807.1 (~Mr), U808.1 (~Mr), U809.1 (~Mr), U810.1 (~Mr), U811.1 (~Mr), U812.1 (~Mr), U813.1 (~Mr), U816.8
CLK: U802.11 (CCK), U807.9 (Cp), U808.9 (Cp), U809.9 (Cp), U810.9 (Cp), U811.9 (Cp), U812.9 (Cp), U813.9 (Cp)
GND: U802.12 (~CCKEN), U802.14 (~EN), U803.1 (VPP), U803.20 (CE), U803.22 (OE), U804.1 (VPP), U804.20 (CE), U804.22 (OE), U805.1 (VPP), U805.20 (CE), U805.22 (OE), U806.1 (VPP), U806.20 (CE), U806.22 (OE), U810.13 (D3), U813.13 (D3)
unnamed: U801.8, U816.1
OPC0: U803.5 (A5), U804.5 (A5), U805.5 (A5), U806.5 (A5)
OPC1: U803.4 (A6), U804.4 (A6), U805.4 (A6), U806.4 (A6)
OPC2: U803.3 (A7), U804.3 (A7), U805.3 (A7), U806.3 (A7)
OPC3: U803.25 (A8), U804.25 (A8), U805.25 (A8), U806.25 (A8)
OPC4: U803.24 (A9), U804.24 (A9), U805.24 (A9), U806.24 (A9)
OPC5: U803.21 (A10), U804.21 (A10), U805.21 (A10), U806.21 (A10)
OPC6: U803.23 (A11), U804.23 (A11), U805.23 (A11), U806.23 (A11)
OPC7: U803.2 (A12), U804.2 (A12), U805.2 (A12), U806.2 (A12)
UC0: U802.15 (Qa), U803.10 (A0), U804.10 (A0), U805.10 (A0), U806.10 (A0)
UC1: U802.1 (Qb), U803.9 (A1), U804.9 (A1), U805.9 (A1), U806.9 (A1)
UC2: U802.2 (Qc), U803.8 (A2), U804.8 (A2), U805.8 (A2), U806.8 (A2)
UC3: U802.3 (Qd), U803.7 (A3), U804.7 (A3), U805.7 (A3), U806.7 (A3)
UC4: U802.4 (Qe), U803.6 (A4), U804.6 (A4), U805.6 (A4), U806.6 (A4)
VCC: U803.27 (~PGM), U804.27 (~PGM), U805.27 (~PGM), U806.27 (~PGM), U814.1, U815.1, U815.2
aluCarryIn: U805.19 (D7), U812.13 (D3)
aluMode: U805.18 (D6), U812.12 (D2)
aluOp0: U805.13 (D2), U811.12 (D2)
aluOp1: U805.15 (D3), U811.13 (D3)
aluOp2: U805.16 (D4), U812.4 (D0)
aluOp3: U805.17 (D5), U812.5 (D1)
aluOut: U805.11 (D0), U811.4 (D0)
ccCarryOut: U814.4
ccEq: U801.1
driveAddr: U803.18 (D6), U808.12 (D2)
end: U813.4 (D0), U815.8
endIfEq: U801.2
endIfNeq: U801.5
endIfNeqCarry: U806.15 (D3), U814.5
endIfNeqNoCarry: U806.16 (D4), U814.11
endIfNoCarry: U814.13
extRW: U803.19 (D7), U808.13 (D3)
latchALU: U804.18 (D6), U810.12 (D2)
latchAddr: U806.18 (D6), U813.5 (D1)
latchCC: U806.19 (D7), U813.12 (D2)
memDir: U803.17 (D5), U808.5 (D1)
pcClk: U805.12 (D1), U811.5 (D1)
rdGP: U803.11 (D0), U807.4 (D0)
rdGP0: U803.12 (D1), U807.5 (D1)
rdGP1: U803.13 (D2), U807.12 (D2)
rdPC: U803.15 (D3), U807.13 (D3)
rwMem: U803.16 (D4), U808.4 (D0)
uAluMode: U812.10 (Q2)
uAluOp0: U811.11 (~Q2)
uAluOp1: U811.14 (~Q3)
uAluOp2: U812.2 (Q0)
uAluOp3: U812.7 (Q1)
uEnd: U813.2 (Q0)
uExtRW: U801.10, U801.13
uMemDir: U801.12, U808.7 (Q1)
uPcClk: U811.6 (~Q1)
uRdGP0: U807.7 (Q1)
uRdGP1: U807.10 (Q2)
uWrGP0: U809.10 (Q2)
uWrGP1: U809.15 (Q3)
wrGP0: U804.13 (D2), U809.12 (D2)
wrGP1: U804.15 (D3), U809.13 (D3)
wrGPHi: U804.12 (D1), U809.5 (D1)
wrGPLo: U804.11 (D0), U809.4 (D0)
wrPCHi: U804.17 (D5), U810.5 (D1)
wrPCLo: U804.16 (D4), U810.4 (D0)

Notes on the sheet:
Counter is advanced on positive clock edges, and counter values are clocked into the register on negative clock edges. So, updated counts appear on negative clock edges.
microcode / control signals
conditional branch logic
condition code signals
ROMs
control signal registers
external memory r/w signals
Note that uMemDir is guaranteed to be correct when -opfetch is asserted, because the ucode unit is under reset and thus uMemdir is 0 (read).
