daveho/cpu2/hw/ucode.sch

## KiCad design hw/ucode.sch (2017-06-24)

Schematic: ucode.sch

Parts:
U501: 74HC590
U502: 74HCT02
U503: 74HCT00
U504, U505: 74HCT238
U506, U507, U508: 27C64
U509, U510, U511, U512, U513, U514, U515, U516: 74HCT175

Notes on the sheet:
microcode
Note: these are '238 decoders with active high outputs, not '138 decoders with active low outputs
ROM 1: Device read/write signals, end signal
Counter is advanced on positive clock edges, and counter values are clocked into the register on negative clock edges. So, updated counts appear on negative clock edges.
unused gates
ROM 2: misc. control signals
ROM 3: ALU control signals
