daveho/cpu2/sim/src/io/github/daveho/logicsim/PinType.java

package io.github.daveho.logicsim;

/**
 * Types of device pin.
 * Pin type is a static feature of a pin.
 */
public enum PinType {
	INPUT,
	OUTPUT,
	OUTPUT_TRISTATE,
	BIDIRECTIONAL,
	BIDIRECTIONAL_TRISTATE,
	POWER_VCC,
	POWER_GND;

	/**
	 * @return initial {@link PinMode} for a pin of this type
	 */
	public PinMode getInitialMode() {
		switch (this) {
		case BIDIRECTIONAL:
			return PinMode.OUTPUT; // device should override initial mode if necessary
		case BIDIRECTIONAL_TRISTATE:
			return PinMode.OUTPUT; // device should override initial mode if necessary
		case INPUT:
			return PinMode.INPUT;
		case OUTPUT:
			return PinMode.OUTPUT;
		case OUTPUT_TRISTATE:
			return PinMode.OUTPUT; // device should override initial mode if necessary
		case POWER_GND:
			return PinMode.INPUT;
		case POWER_VCC:
			return PinMode.INPUT;
		default:
			throw new IllegalStateException("Unknown pin mode: " + this);
		}
	}
	
	/**
	 * Determine whether a pin of this type can be set to
	 * a given {@link PinMode}.
	 * 
	 * @param mode a {@link PinMode}
	 * @return true if this type of pin can be set to the specified mode, false otherwise
	 */
	public boolean canSetMode(PinMode mode) {
		switch (this) {
		case BIDIRECTIONAL:
			return mode == PinMode.INPUT || mode == PinMode.OUTPUT;
		case BIDIRECTIONAL_TRISTATE:
			return true; // can be set to any mode
		case INPUT:
			return mode == PinMode.INPUT;
		case OUTPUT:
			return mode == PinMode.OUTPUT;
		case OUTPUT_TRISTATE:
			return mode == PinMode.OUTPUT || mode == PinMode.HI_Z;
		case POWER_GND:
			return mode == PinMode.INPUT;
		case POWER_VCC:
			return mode == PinMode.INPUT;
		default:
			throw new IllegalStateException("Unknown pin mode: " + this);
		}
	}
}
