daveho/cpu2/(commit log)

2017-04-23 working on assembler
2017-04-23 successfully parsed a simple assembly file
2017-04-25 Simulation's prepare() method guarantees every pin is connected to a net
2017-04-25 renamed DeviceOutputs as DeviceGen
2017-04-25 minor refactoring; add test case with nand gates as SR latch
    The refactoring is to add a createNet(String) method to
    Simulation to create and add a Net. This is easier
    than creating the Net and adding it in separate steps.
2017-04-25 print out how many updates are needed until equilibrium is reached
2017-04-25 implement Device7402, quad two-input NOR gates
    Also, fix implementation of Device7400: the gates were
    actually implementing NOR rather than NAND. Surprisingly,
    this doesn't really affect the SR latch.
    [Simulation.java]
2017-04-25 introduce concept of "Unit", related input and output pins (e.g., gate)
    Allows entirety of a multi-unit device to be tested easily.
2017-04-25 general support for testing any quad two-input device
2017-04-25 rename SimulationTest* to Device7400Test, SRLatchTest
2017-04-25 added Device7402Test
2017-04-25 added Device7404 and Device7404Test
    Also, refactored GateTest out of QuadGateTest, for general testing
    of any device with arbitrary number of gates and arbitrary number
    of inputs per gate.
2017-04-25 added Device7408 and Device7408Test
2017-04-26 move Device7408 to correct source folder
2017-04-26 added Device7432 and Device7432Test
2017-04-26 added Device7486 and Device7486Test
2017-04-26 added Device74574 (octal D-type flip flips with tristate outputs)
    [PinType.java, Simulation.java]
2017-04-26 added Device74374, DeviceOctalDTypeFFTristate
    The '374 is functionally identical to the '574, so it makes
    sense to support both.
2017-04-27 started Device74574Test
2017-04-30 have Device cache Units, add DeviceQuadTwoInputGate
    DeviceQuadTwoInputGate serves as a common implementation for
    all of the quad two-input gate devices: '00, '02, '08, etc.
2017-05-02 create a Unit for octal D-type flip flop devices
    Each such device has a single unit, grouping all 8
    input pins and output pins into ports.
2017-05-02 started Device74138
2017-05-02 use ports to simplify data operations for octal flip flop devices
2017-05-02 implement Device74138 logic, add Device74138Test
    Also, some minor refactoring in creating IO units
    to allow numbers of input and output pins to be different.
2017-05-02 added Device74670 and Device74670Test
    The '670 is one of my favorite ICs.
2017-05-06 starting to think about hardware units
    [cpu2.kicad_pcb, cpu2.sch]
2017-05-09 annotated components
    [cpu2.sch]
2017-05-09 implemented lexer for Kicad netlist files
2017-05-11 implemented kicad netlist parser
2017-05-13 working on building a Simulation from a Kicad netlist
2017-05-14 create nets and connect device pins to nets
    This should be about it for being able to load Kicad netlists
    (aside from fixing bugs).
    [Simulation.java]
2017-05-16 working on Device74191, 4-bit up/down counter with parallel load
    This one is much more complicated than the other devices.
    Will need to compare behavior to actual chip.
2017-05-22 opcode fetch logic
    [opfetch.kicad_pcb, opfetch.sch]
2017-05-22 added the actual opcode register
    [opfetch.sch]
2017-05-23 initial checkin
    [pc.kicad_pcb, pc.sch]
2017-05-23 added pair of '541 buffers for output to addr bus
    [pc.sch]
2017-05-23 more accurate bus net labels
    ALU data bus is ALU0..ALU7.
    Left ALU input bus is LEFT0..LEFT7.
    Right ALU input bus is RIGHT0..RIGHT7.
    [pc.sch]
2017-05-24 early reset logic
    [earlyrst.kicad_pcb, earlyrst.sch]
2017-05-24 comment about -pcLoad signal
    [earlyrst.sch]
2017-05-25 annotate schematic, note unused or gate
    [earlyrst.sch]
2017-05-25 finally, a working version
    [earlyrst.sch]
2017-05-26 organize using hierarchical sheets, add opfetch logic
    Also, updated the opcode fetch logic to generate an
    opFetchEnd signal, to let the phase logic know that
    the opcode fetch is done (and microcode execution
    can start.)
    [cpu2.sch, gpreg.sch, opfetch.sch]
2017-05-27 fix opcode fetch logic
    opFetchEnd was going high too early
    [cpu2.sch, gpreg.sch, opfetch.sch]
2017-05-27 started phase logic
    [cpu2.sch, gpreg.sch, opfetch.sch, phase.sch]
2017-05-28 clean up opfetch, finishing touches on phase logic
    [cpu2.sch, opfetch.sch, phase.sch]
2017-05-28 added early reset logic as hierarchical sheet
    [cpu2.sch, earlyrst.sch, gpreg.sch, opfetch.sch, phase.sch]
2017-05-28 added program counter as hierarchical sheet
    [cpu2.sch, earlyrst.sch, gpreg.sch, opfetch.sch, pc.sch, phase.sch]
2017-05-28 removed separate projects for opfetch, pc, earlyrst
    Everything is now in the main schematic, with components
    organized as hierarchical sheets.
    [earlyrst.kicad_pcb, earlyrst.sch, opfetch.kicad_pcb, opfetch.sch, pc.kicad_pcb, pc.sch]
2017-05-29 redesign of early reset logic
    Use a '393 counter to generate delayed high signals for
    -wrPC (write the PC high/low registers), -initPC
    (assert the initial PC byte value on the ALU data bus),
    and -lateRST (reset signal for other components.)
    This (hopefully) fixes an issue with the previous design
    where the initial PC value was clocked in on the same
    clock edge as the one that de-asserted the driving of
    the initial PC byte value onto the ALU data bus.
    [cpu2.sch, earlyrst.sch, gpreg.sch, opfetch.sch, pc.sch, phase.sch]
2017-05-29 started microcode logic
    [cpu2.sch, earlyrst.sch, gpreg.sch, opfetch.sch, pc.sch, phase.sch, ucode.sch]
2017-05-29 working on device read/write signals
    We will need to use the inverted outputs from the '175
    flip flops latching the microcode signals in order to
    ensure that the device-specific read/write signals are
    high on reset. This means using positive logic for
    decoding the device ids. NOR gates do the trick for
    the GP registers, and the '238 decoder does the other
    devices (it produces active high outputs, rather than
    active low like the '138 decoder.)
    [ucode.sch]
2017-06-01 started working on ucode assembler
2017-06-06 start working on assembling microcode words
2017-06-06 working on assembling microcode instructions
2017-06-06 print out ucode instruction words: seems to work
2017-06-08 added clock/reset circuit
    [clockrst.sch, cpu2.sch, earlyrst.sch, gpreg.sch, opfetch.sch, pc.sch, phase.sch, ucode.sch]
2017-06-08 protoclock firmware (for clock/reset circuit)
    [protoclock.c]
2017-06-08 adding component references
    [cpu2.sch, earlyrst.sch, phase.sch]
2017-06-08 annotated more components
    Also some more work on connecting modules together
    and adding glue logic.
    [cpu2.sch, opfetch.sch, pc.sch, ucode.sch]
2017-06-08 added ucode output registers
    [earlyrst.sch, opfetch.sch, phase.sch, ucode.sch]
2017-06-10 eliminated pcClkEn signal
    There's no need to selectively enable/disable
    the count function in the PC because the PC
    clock signal (pcClk) is generated explicitly
    by the microcode, and clock pulses are sent
    only when we actually want to increment the PC
    value.
    This allowed a simplicification of the carry
    logic, and eliminated the need for the 74HC30
    in the last stage of the carry logic.
    [cpu2.sch, pc.sch, ucode.sch]
2017-06-10 fix PC carry logic
    [pc.sch]
2017-06-11 tweak opfetch logic to increment PC
    [opfetch.sch]
2017-06-12 more work on glue logic
    [cpu2.sch, opfetch.sch]
2017-06-13 moved PC glue logic to PC schematic
    I think it would be best to keep all of the logic
    to the individual schematics, rather than putting
    any in the main schematic. More modular that way.
    [cpu2.sch, pc.sch]
2017-06-13 added reset/disable logic to ucode, connect CLK
    [cpu2.sch, ucode.sch]
2017-06-13 add hierarchical pins for ucode module
    [cpu2.sch]
2017-06-13 added input signals to ucode module
    [cpu2.sch]
2017-06-13 added nets for ucode outputs to PC module
    [cpu2.sch]
2017-06-13 make main schematic larger, add title
    [cpu2.sch]
2017-06-16 fixed PC control logic
    [pc.sch]
2017-06-16 use unused NAND gates as inverters
    This means we only need one '02, rather than 2.
    [ucode.sch]
2017-06-19 started ALU
    [alu.sch, clockrst.sch, cpu2.sch, earlyrst.sch, gpreg.sch, opfetch.sch, pc.sch, phase.sch]
2017-06-19 initial stab at ALU circuit
    [alu.sch, cpu2.sch]
2017-06-20 vim syntax file for microcode assembly
2017-06-21 use a 74HC175 for the condition code register
    It's possible that the inverted outputs will be
    useful in implementing the logic that uses the
    condition codes (e.g., conditional branches).
    [alu.sch]
2017-06-21 connect ALU on top-level schematic
    Also, export the negated versions of the condition
    code signals (in case they are useful.)
    [alu.sch, cpu2.sch]
2017-06-21 get prefix label in the right place
    [cpu2.sch]
2017-06-21 use 74HC590 as microcode program counter
    The 74HC393 can only advance bit 5 using a ripple
    carry from the lower 4 bit counter, which I am
    concerned would be too slow (especially given the
    slowness of the microcode EPROMS, which
    must generate a value output within a half
    of one clock cycle). The 74HC590 is a
    proper 8 bit counter, which I assume has fast
    carry logic internally.
    [alu.sch, clockrst.sch, cpu2.sch, earlyrst.sch, gpreg.sch, opfetch.sch, pc.sch, phase.sch]
2017-06-21 fleshing out full set of microcode signals
    This won't be the final version: the signals for
    reading from a device will be different. There is no
    need to have separate signals for reading the high
    and low registers for register pairs (e.g., PCHi
    and PCLo) because the ALU can select which one should
    be sent to the ALU data bus. So, only 3 bits are needed
    to specify which device is being read, as long as
    the appropriate ALU operation is asserted to select
    the data from the left or right ALU bus.
2017-06-22 added support for patterns (combinations of signals)
    Doesn't quite work yet, need to debug.
    Also, changed microcode to account for the idea that
    when reading, a device pair is asserted into the
    left/right ALU input busses, and then the ALU is used
    to select the desired value for output onto the ALU
    data bus.
2017-06-22 redoing device read logic
    [cpu2.sch, ucode.sch]
2017-06-22 more redesign of microcode
    Reading and writing devices and ALU control are
    mostly in place.
    Eliminated the dedicated signals to assert device pairs
    to the left/right ALU input busses. These aren't needed
    any more because all reading from devices is done using
    pairs (with the ALU to select which one is copied to the
    ALU data bus.)
    [ucode.sch]
2017-06-22 more fleshing out of microcode circuit
    [ucode.sch]
2017-06-22 move end signal to first microcode ROM
    [ucode.sch]
2017-06-24 microcode redesign
    Rather than using logic to decode "packed" data
    from the microcode, just use a 1:1 assignment of
    microcode bits to control signals. Since it looks
    like 32 control signals will be sufficient, 4
    microcode ROMs will do us. Eliminating the
    decoding logic reduces the chip count, and should
    also result in better performance, since the
    signals from the ROMs are clocked directly into
    the '175 registers.
    [alu.sch, clockrst.sch, cpu2.sch, earlyrst.sch, gpreg.sch, opfetch.sch, pc.sch, phase.sch]
2017-06-25 models for breadboard retention clip
    The idea is that these can be screwed to a flat surface
    to keep the breadboards in place.
    [base.scad, top.scad]
2017-06-26 switch over to ucode2 module for microcode
    [cpu2.sch]
2017-06-26 add unused gates to ucode2 schematic
    [alu.sch, clockrst.sch, cpu2.sch, earlyrst.sch, gpreg.sch, opfetch.sch, pc.sch, phase.sch]
2017-06-26 ensure ALU mode is selected for device reads
2017-06-28 make ROM 3 the ALU control ROM
    Need to think about how to handle conditional branch
    logic (e.g., "end if equal", "end if not equal",
    etc.)
    [ucode2.sch]
2017-06-28 regroup ALU signals
    Specifically, put the 4 ALU operation signals
    so that they appear as outputs of a single '175
    register.
    [ucode2.sch]
2017-06-28 route ALU ROM signals to the correct inputs
    [ucode2.sch]
2017-06-28 implemented conditional branch logic
    This requires us to put some combinational logic
    behind the '175 registers, based on condition code
    signals. Adds three chips. Also, added microcode
    signals to drive the external address bus and to
    send an increment pulse to the program counter.
    There are only two unused microcode bits at this
    point!
    [ucode2.sch]
2017-06-28 added uEnd output, use custom sheet size
    [ucode2.sch]
2017-06-28 -endUncond needs to be active-low
    Also, fixed mistaken placement of -uDriveAddr
    output.
    [alu.sch, clockrst.sch, ucode2.sch]
2017-06-29 use unused AND gate to allow 2 PC output enables
    Both the opfetch logic and the microcode need to be
    able to assert the contents of the PC onto the
    left and right ALU input busses.
    [cpu2.sch, pc.sch]
2017-06-29 clean up top-level schematic
    Just label inputs and outputs to each module.
    Running wires everywhere is just confusing.
    [cpu2.sch]
2017-06-29 implement GP registers
    Also, add ucode signals to main sheet, and do
    some cleanup on main sheet.
    [cpu2.sch, gpreg.sch]
2017-06-29 added bus/address register module
    Used a '245 bus transceiver to do reads from
    and writes to the external data bus, so the
    control signals for reading and writing memory
    changed (to -rwMem and memDir, rather than
    separate read and write signals.)
    At this point, I think all of the required modules
    are in place, although not all of the connections are
    shown on the top-level schematic.
    [alu.sch, bus_ar.sch, clockrst.sch, cpu2.sch, earlyrst.sch, gpreg.sch, opfetch.sch, pc.sch]
2017-06-29 finish connections on top-level schematic
    A lot of careful inspection is necessary, but at this
    point all of the hardware components should be in place
    (unless I am totally missing something.)
    [cpu2.sch]
2017-06-29 connect condition code signals to ucode module
    These are needed by the conditional branch logic.
    [cpu2.sch]
2017-06-29 specify prefix for bus_ar module
    [cpu2.sch]
2017-06-29 add assert/deassert for one-bit signals
    assert changes a one-bit signal to the negation
    of its default value.
    deassert changes a one-bit signal back to its
    default value.
    This is very useful for asserting and deasserting
    device control lines such as read and write signals.
2017-06-29 added missing ALU inputs from microcode
    [cpu2.sch]
2017-06-29 connected one more ALU input signal
    [cpu2.sch]
2017-07-03 fix a couple of minor errors
    [alu.sch, bus_ar.sch]
2017-07-03 use a buffer to replicate clock/reset signals
    In particular, this allows us to limit the clock fan-out
    to 8 inputs.
    [clockrst.sch, cpu2.sch]
2017-07-03 indicate HC series part for clock/reset buffer
    [clockrst.sch]
2017-07-03 use -lateRST as input to phase, opfetch, ucode2
    Not -RST! That should only go to earlyrst.
    [cpu2.sch]
2017-07-03 add note about protoclock firmware
    [clockrst.sch]
2017-07-03 simplified control of output to left/right busses
    [pc.sch]
2017-07-12 have AR regs output to the low/high addr busses
    For store instructions, a GP register pair is used
    to specify the address, AND a GP register specifies
    the data. This means we can't drive the address
    bus directly from a GP register pair, since that
    wouldn't allow us to output the correct data. So,
    the contents of the GP register pair specifying the
    address must be transferred into the AR registers,
    which can then drive the address, allowing the
    correct GP register data to be output via the ALU.
    Will need to add a microcode signal for driving the
    address bus from the AR registers.
    [bus_ar.sch]
2017-07-12 started template for store to memory
    It's complicated because it involves a transfer
    from a GP register pair to AR, but I think it should
    be on the right track.
    It occurs to me that we will need external memory
    read/write signals. Shouldn't be a problem, since
    we have unused microcode bits and unused '175 flip
    flops.
    Note about previous commit: we actually don't need a
    new microcode signal for asserting AR onto the address
    busses, since the existing rdAR signal can do this.
    (Note that we lose the ability to read the AR regs
    onto the left/right ALU input busses, but that should
    be ok.)
2017-07-13 use '573 latches as address bus drivers
    This let's us latch the address being asserted onto
    the left/right ALU inputs busses in case it is going
    to change during the execution of the instruction.
    [bus_ar.sch, cpu2.sch, ucode2.sch]
2017-07-15 generate external r/w signals
    Found a way to do this without increasing the chip
    count: use NAND gates to produce some of the conditional
    end signals (rather than OR gates), and use AND gates
    to generate the -ucodeRST signal and the new
    extW/extR signals. These are active high, and
    are generated as inverted, ensuring that the
    final -uExtW and -uExtR signals are not asserted
    on reset.
    [ucode2.sch]
2017-07-19 do combinational logic for ext r/w after FFs
    This should work fine, and allows for one more microcode
    signal for latching the ALU condition codes, which I'm
    pretty sure we will need.
    [ucode2.sch]
2017-07-19 add -uExtW/-uExtR signals to main schematic
    Also, don't need to export the -uExtRW signal via a
    hierarchical pin.
    [cpu2.sch, ucode2.sch]
2017-07-23 add explicit signal to latch condition codes
    Was able to use microcode bits more efficiently (to make
    room for the new signal) by putting the combinational
    logic to generate the external read/write signals after
    the '175 microcode signal registers. This should be fine
    as long as memDir is set appropriately before the extRW
    signal is asserted. (No glitches should be possible.)
    [alu.sch, cpu2.sch, ucode2.sch]
2017-07-23 tweaks to ALU schematic for readability
    [alu.sch]
2017-07-25 initial support for assembling ucode instructions
2017-07-25 store assembled instructions
2017-07-29 remove AR registers, switch to new ucode impl
    Note that there is a bug in the ucode module:
    the -uExtW and -uExtR signals are generated incorrectly.
    (They need to be OR gates, not AND gates, so that
    they can be held high when -uExtRW is not asserted.)
    [bus_ar.sch, cpu2.sch, ucode2.sch]
2017-07-29 fix logic generating -uExtW/-uExtR signals
    [ucode2.sch]
2017-08-01 account for opfetch for -uExtR and -uRwMem
    -uExtR should be asserted whenever -opReadMem is asserted,
    and -uRwMem should be asserted whenever -opfetch is asserted.
    Did this without additional chips, at the cost of requiring
    74HCT10 rather than 74HCT20 in the conditional branch logic.
    (Will have to buy these, but I've seen them on ebay.)
    Also renumbered some of the chips in the ucode2 module
    so that the numbering reflects the actual number of chips
    (16).
    Will need to carefully double check this to make sure it's
    correct.
    [pc.sch, ucode2.sch]
2017-08-06 add missing signals to/from ucode2 module
    Also, use a custom page size for the top-level
    schematic.
    [cpu2.sch, ucode2.sch]
2017-08-06 allow -opfetch to drive address to addr bus
    This is necessary during opfetch, when the microcode
    module does not assert -uDriveAddr on its own.
    [ucode2.sch]
2017-08-10 replace '193 with '393 in opfetch module
    The '393 has two fewer pins, better use of breadboard space.
    [cpu2.sch, opfetch.sch, pc.sch]
2017-08-10 set correct device # and value for '393 counter
    [opfetch.sch]
2017-08-15 buffer clock/reset signals in earlyrst module
    This is the place that makes sense because the late
    reset signal is the one that matters to the rest
    of the circuit.
    [clockrst.sch, cpu2.sch, earlyrst.sch]
2017-08-15 simplified control of initial PC output
    Just tie one of the '541 buffer's output enables to
    ground, and control the other one using the -initPC
    signal.
    [earlyrst.sch]
2017-08-15 allow ALU output to be latched
    We can do this with essentially no increase in
    complexity, using a '573 latch rather than a '541
    buffer for the ALU output. I'm guessing this
    might be useful for some instructions (to hold the
    ALU output constant when its inputs might be
    changing.)
    [alu.sch, cpu2.sch, ucode2.sch]
2017-08-17 gate swap to simplify wiring
    [phase.sch]
2017-08-19 clock '393 using non-inverted clock signal
    It counts on high to low pulses, and so advance before
    the '175 register clocks in the logic values produced
    by the combinational logic.
    [cpu2.sch, opfetch.sch]
2019-10-19 upgraded to KiCad 5.x project
